TannerOleksiuk/ECE299/AlarmClock/schem.pdf

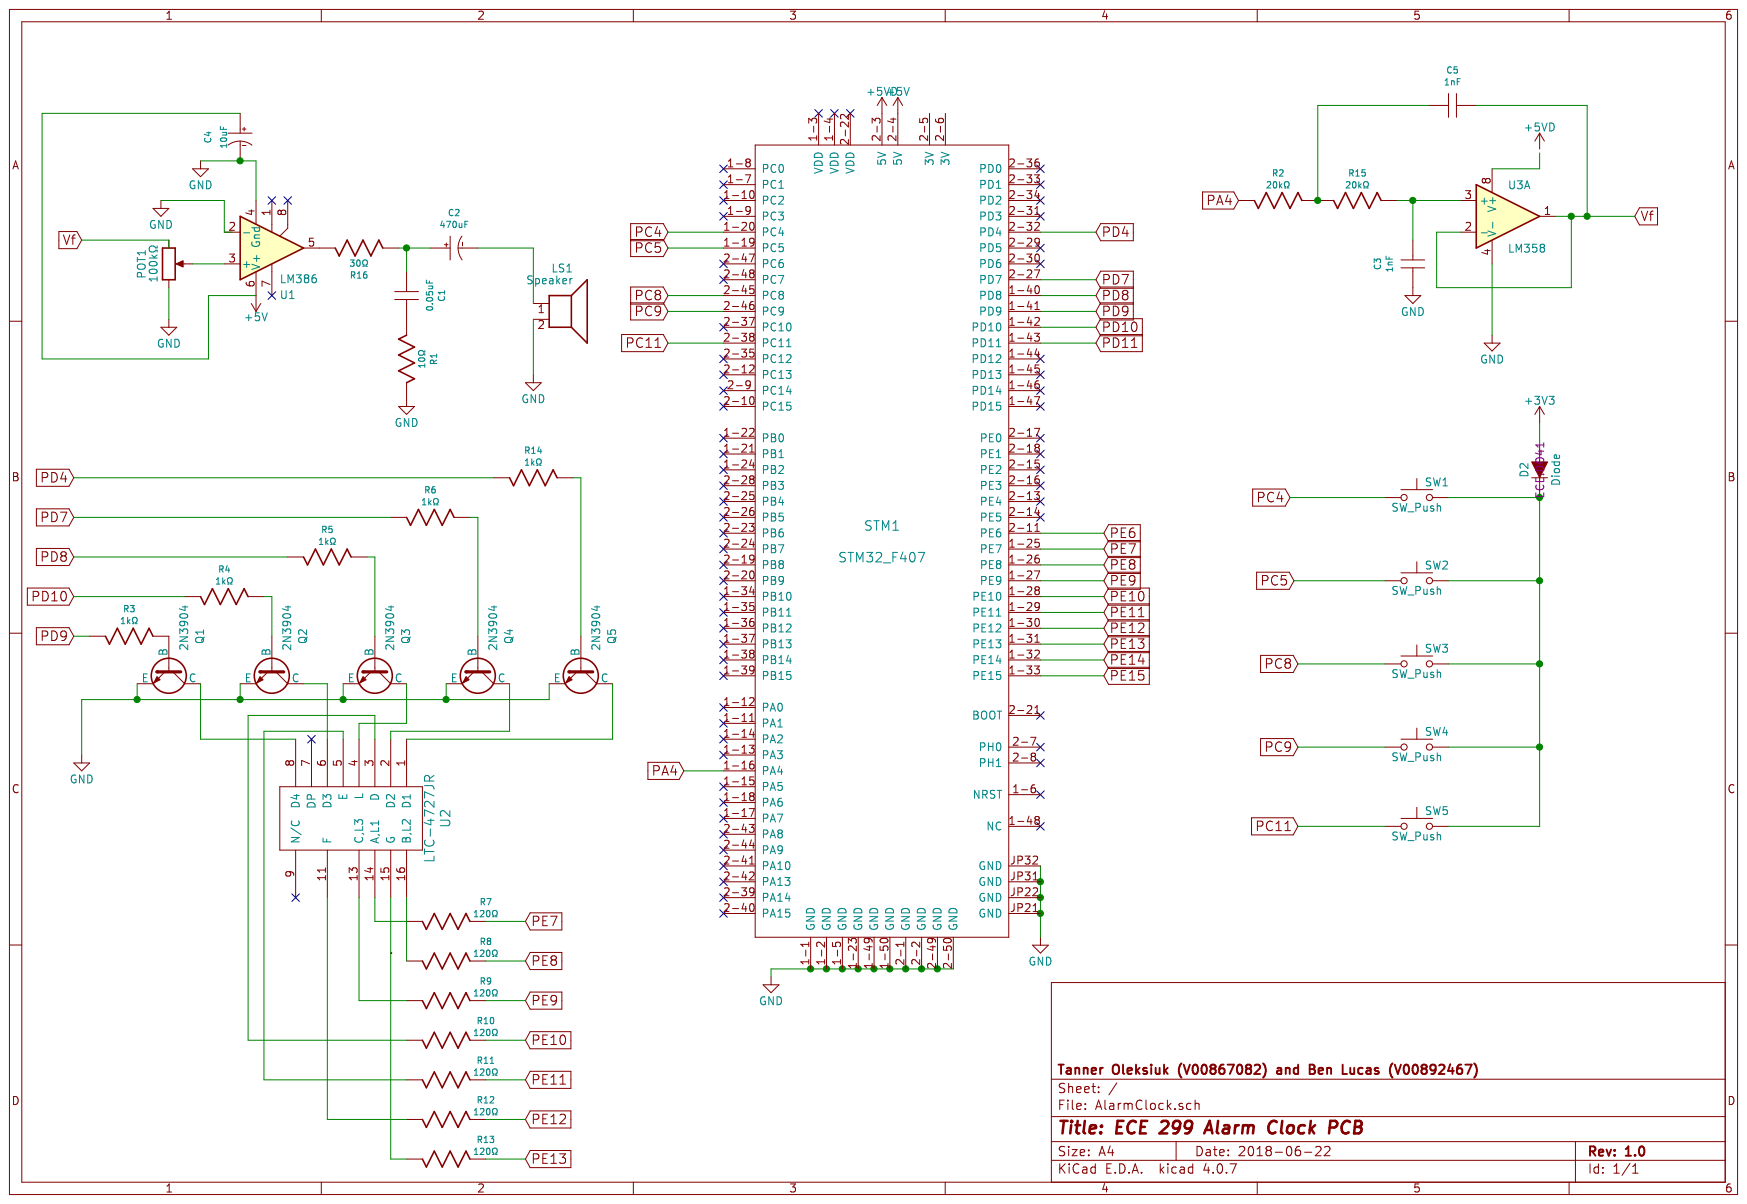
[picture p1: page 1]
