TannerOleksiuk/ECE299/AlarmClock/AlarmClock.kicad_pcb

## KiCad design AlarmClock/AlarmClock.kicad_pcb (2018-07-05)

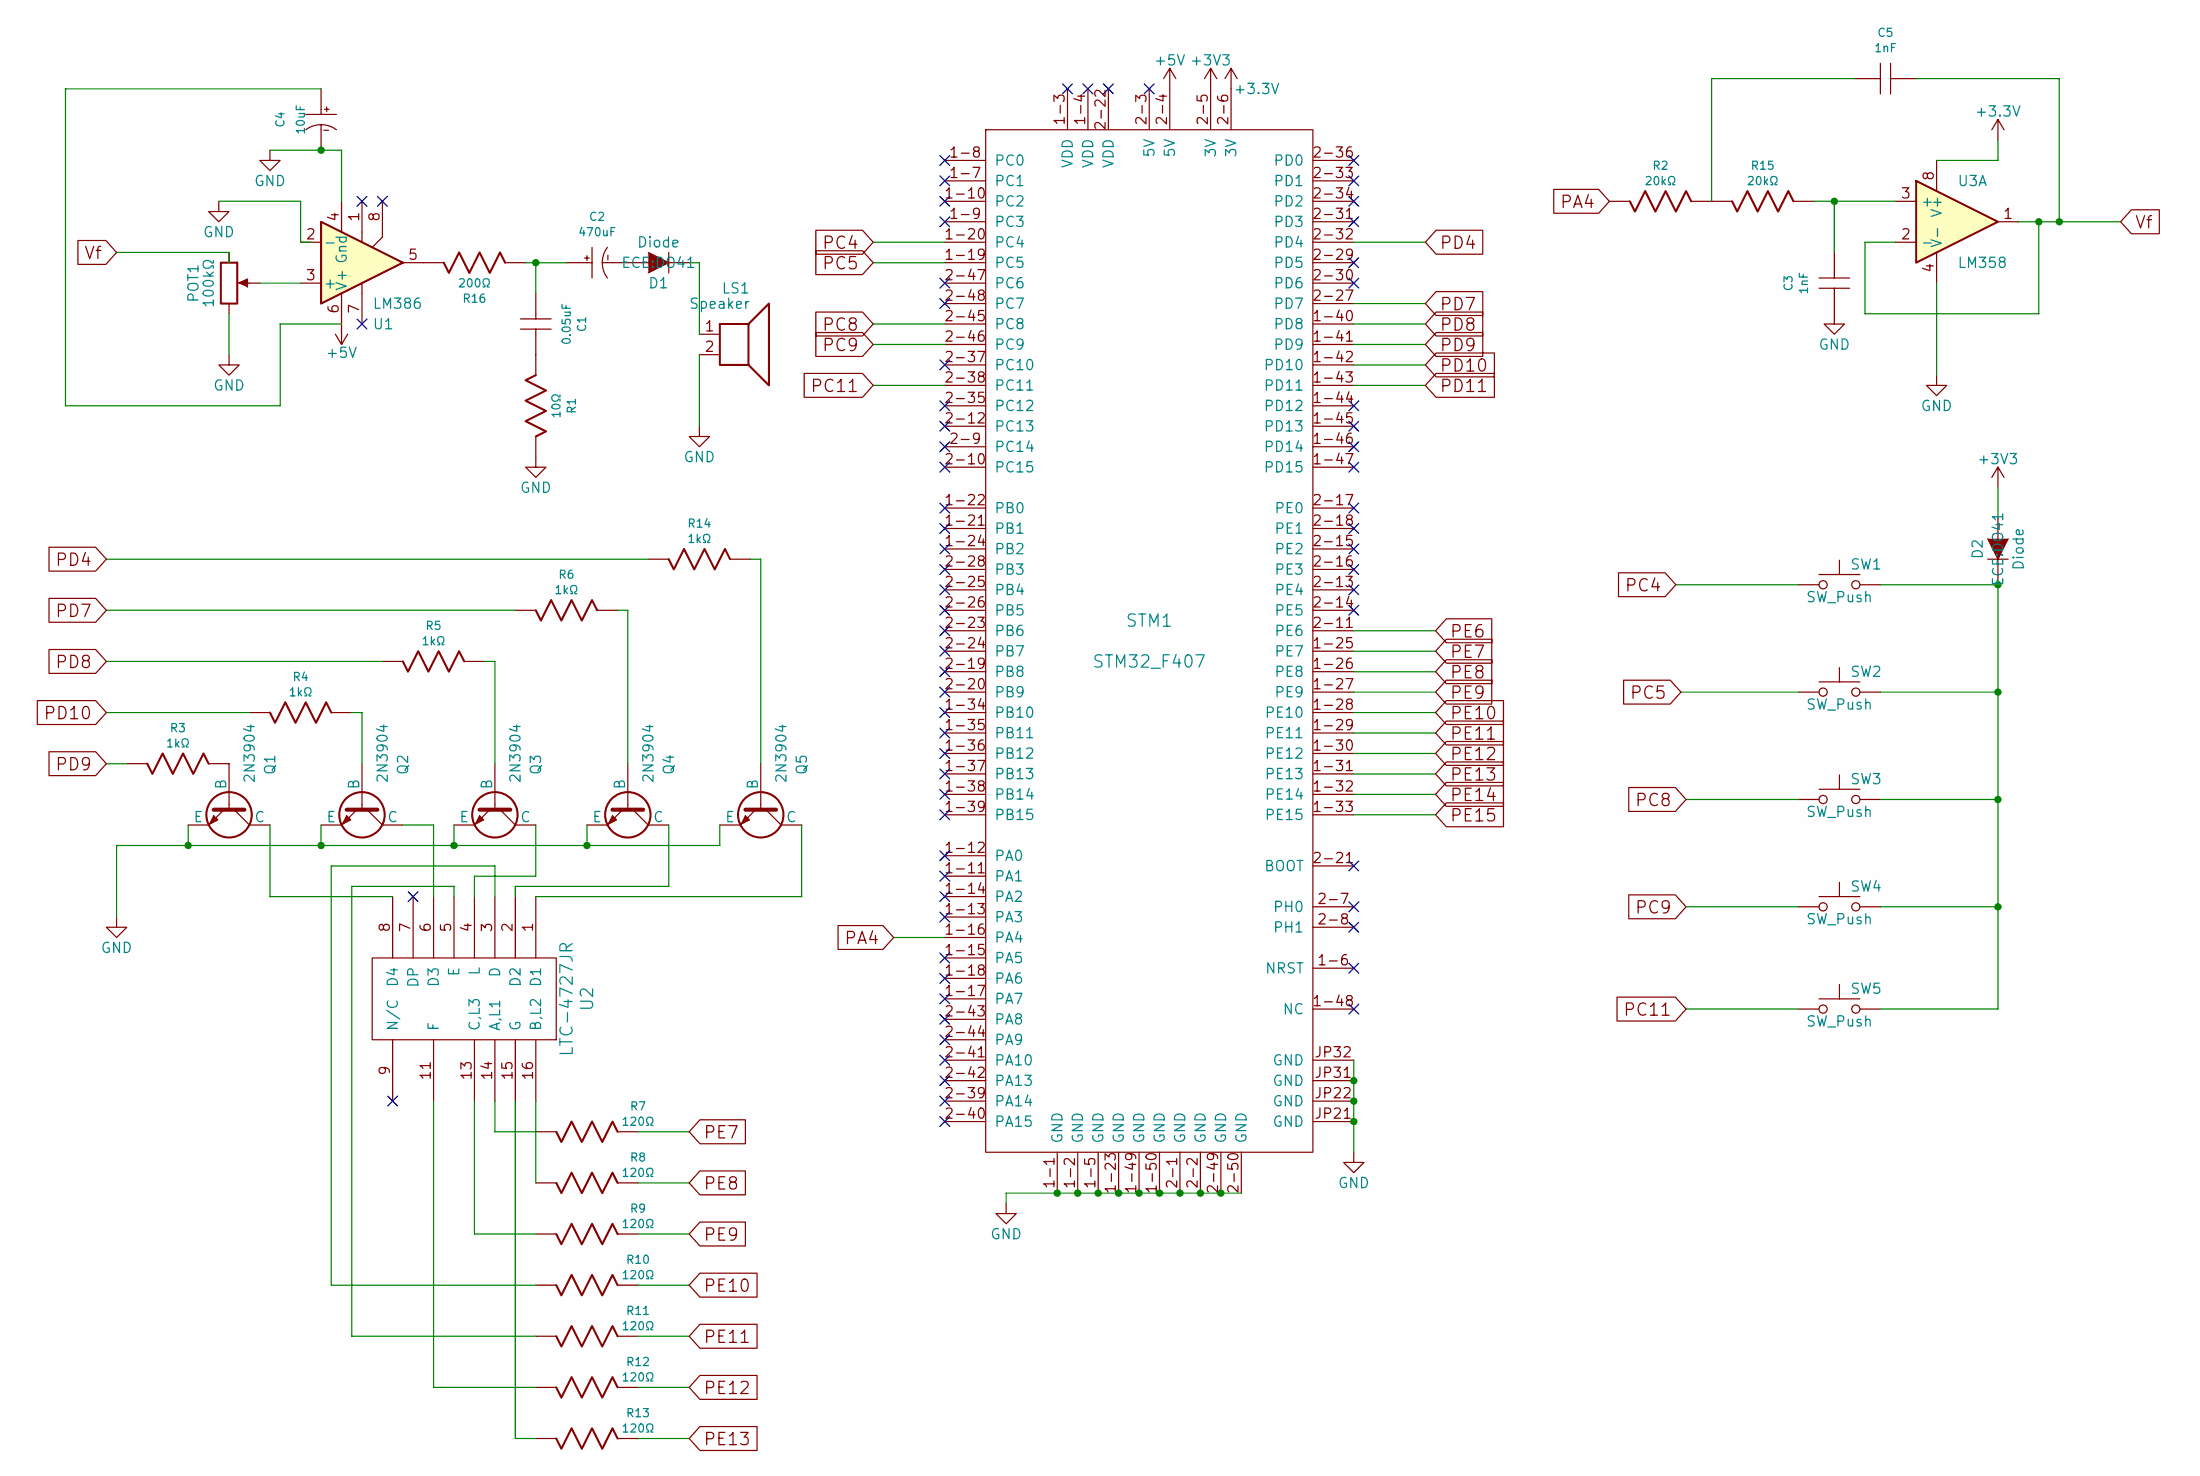
[picture p2: schematic AlarmClock.sch, ECE 299 Alarm Clock PCB]

Parts:
C1: 0.05uF; CAP.1
C2: 470uF; CAP_Pol_D6.3xH11.5xP2.0mm
C3, C5: 1nF; CAP.1
C4: 10uF; CAP_Pol_D6.3xH11.5xP2.0mm
D1, D2: Diode; DO41
LS1: Speaker; WireConnection_1.00mmDrill
POT1: 100kΩ; Potentiometer_Alps_RK09K_Horizontal
Q1, Q2, Q3, Q4, Q5: 2N3904; TO92
R1: 10Ω; RES.3
R2, R15: 20kΩ; RES.3
R3, R4, R5, R6, R14: 1kΩ; RES.3
R7, R8, R9, R10, R11, R12, R13: 120Ω; RES.3
R16: 200Ω; RES.3
STM1: STM32_F407; STM32_F4
SW1, SW2, SW3, SW4, SW5: SW_Push; SW_PUSH_6mm
U1: LM386; DIP8
U2: LTC-4727JR
U3: LM358; DIP8

Connections:
+5V: C4.1 (+), STM1.2-4 (5V), U1.6 (V+)
GND: C3.2, C4.2 (-), LS1.2, POT1.3, Q1.1 (E), Q2.1 (E), Q3.1 (E), Q4.1 (E), Q5.1 (E), R1.1, STM1.1-1 (GND), STM1.1-2 (GND), STM1.1-5 (GND), STM1.1-23 (GND), STM1.1-49 (GND), STM1.1-50 (GND), STM1.2-1 (GND), STM1.2-2 (GND), STM1.2-49 (GND), STM1.2-50 (GND), STM1.JP21 (GND), STM1.JP22 (GND), STM1.JP31 (GND), STM1.JP32 (GND), U1.2 (-), U1.4 (Gnd), U3.4 (V-)
unnamed: C1.1, C2.1 (+), R16.2
unnamed: C1.2, R1.2
unnamed: C2.2 (-), D1.A (Anode)
unnamed: C3.1, R15.1, U3.3 (+)
unnamed: C5.2, R2.1, R15.2
unnamed: D1.K (Cathode), LS1.1
unnamed: D2.K (Cathode), SW1.2, SW2.2, SW3.2, SW4.2, SW5.2
unnamed: POT1.2, U1.3 (+)
unnamed: Q1.2 (B), R3.1
unnamed: Q1.3 (C), U2.8 (D4)
unnamed: Q2.2 (B), R4.1
unnamed: Q2.3 (C), U2.6 (D3)
unnamed: Q3.2 (B), R5.1
unnamed: Q3.3 (C), U2.4 (L)
unnamed: Q4.2 (B), R6.1
unnamed: Q4.3 (C), U2.2 (D2)
unnamed: Q5.2 (B), R14.1
unnamed: Q5.3 (C), U2.1 (D1)
unnamed: R7.2, U2.14 (A,L1)
unnamed: R8.2, U2.16 (B,L2)
unnamed: R9.2, U2.13 (C,L3)
unnamed: R10.2, U2.3 (D)
unnamed: R11.2, U2.5 (E)
unnamed: R12.2, U2.11 (F)
unnamed: R13.2, U2.15 (G)
unnamed: R16.1, U1.5
PA4: R2.2, STM1.1-16 (PA4)
PC4: STM1.1-20 (PC4), SW1.1
PC5: STM1.1-19 (PC5), SW2.1
PC8: STM1.2-45 (PC8), SW3.1
PC9: STM1.2-46 (PC9), SW4.1
PC11: STM1.2-38 (PC11), SW5.1
PD4: R14.2, STM1.2-32 (PD4)
PD7: R6.2, STM1.2-27 (PD7)
PD8: R5.2, STM1.1-40 (PD8)
PD9: R3.2, STM1.1-41 (PD9)
PD10: R4.2, STM1.1-42 (PD10)
PD11: STM1.1-43 (PD11)
PE6: STM1.2-11 (PE6)
PE7: R7.1, STM1.1-25 (PE7)
PE8: R8.1, STM1.1-26 (PE8)
PE9: R9.1, STM1.1-27 (PE9)
PE10: R10.1, STM1.1-28 (PE10)
PE11: R11.1, STM1.1-29 (PE11)
PE12: R12.1, STM1.1-30 (PE12)
PE13: R13.1, STM1.1-31 (PE13)
PE14: STM1.1-32 (PE14)
PE15: STM1.1-33 (PE15)
Vf: C5.1, POT1.1, U3.1, U3.2 (-)

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
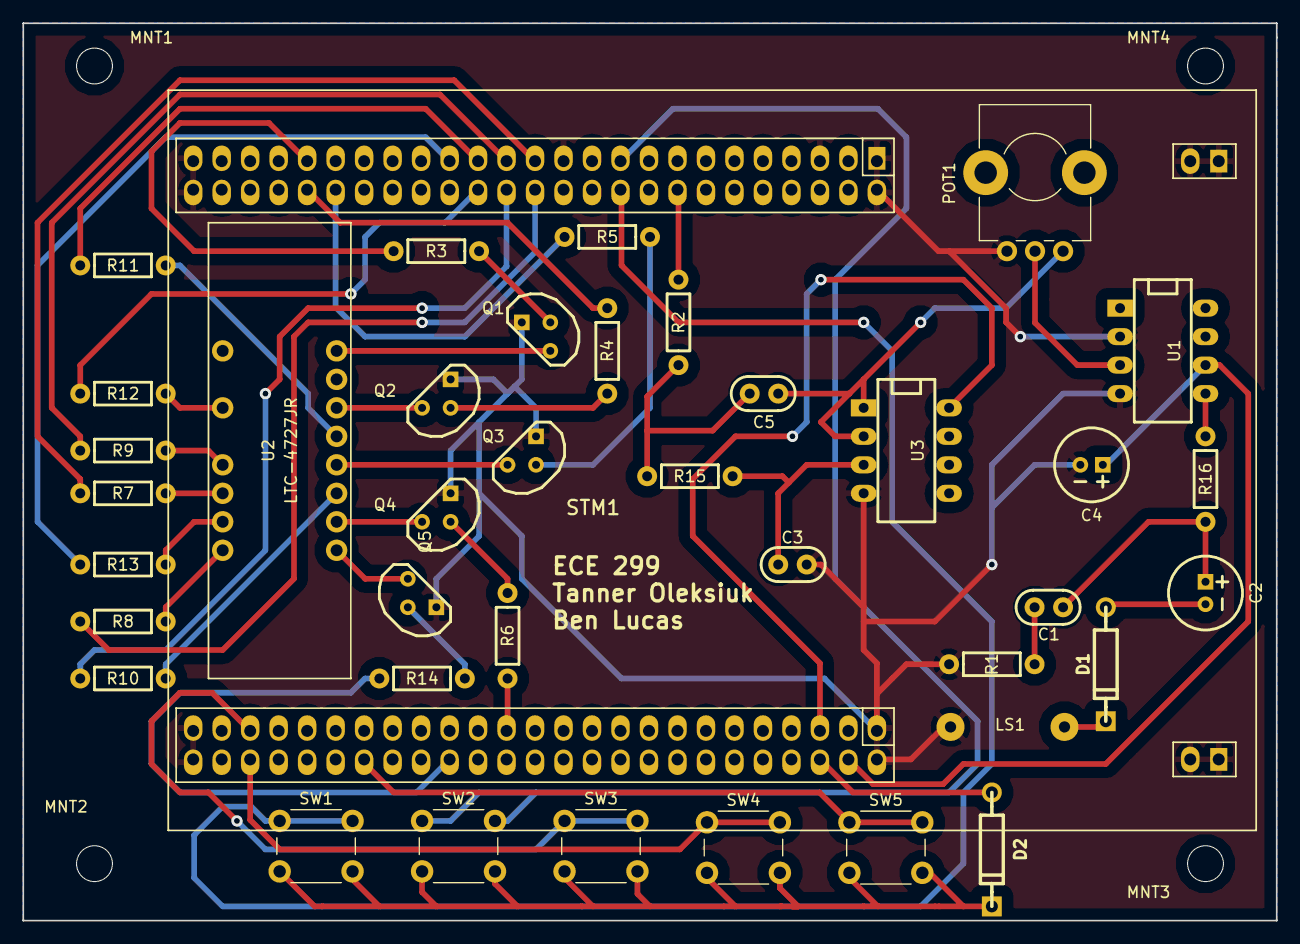
[picture p3: board AlarmClock.kicad_pcb from above]

Board: 2 copper layers, 111.8 x 80.0 mm, 43 parts (0 on the bottom side), 48 nets.

Other parts of the board:
MNT1, MNT2, MNT3, MNT4: MountingHole_3.2mm_M3
