TannerOleksiuk/ECE299/(commit log)

2018-06-15 KiCAD Files
    [AlarmClock.kicad_pcb, AlarmClock.sch]
2018-06-15 Added op amp circuit
    [AlarmClock.sch]
2018-06-19 STM Board added to op amp schematic
    [AlarmClock.sch]
2018-06-21 added labels to STM
    [AlarmClock.sch]
2018-06-21 7 seg
    [ECE 299 project.sch]
2018-06-21 changed name of 7segment for clarity
    [7Segment.sch]
2018-06-21 blah blah blah
    [7Segment.sch]
2018-06-21 push button circuit added
    [AlarmClock.sch]
2018-06-22 finalized for now...
    we should add circuit protection and stuff at some point but honestly its probably fine for assignment submission. Also added a cap between supply voltage and ground since as we saw in the lab, that filtered out a lot of the noise in our input signal, kinda guesstimated it but added space for optional capacitor
    [AlarmClock.sch]
2018-06-29 fixed op amp circuit and 7-seg
    [AlarmClock.sch]
2018-06-29 Modified schematic to include low pass filter and removed PB circuit
    [AlarmClock.sch]
2018-06-29 final schem
    [AlarmClock.sch]
2018-06-30 Added Footprints
    Added footprints to all components except 100kOhm potentiometer, also we need to add push buttons and figure out how they are going to work with the pull up/down resistors in the stm board
    [AlarmClock.sch]
2018-07-03 added pushbuttons
    [AlarmClock.sch]
2018-07-05 geber files and final pcb
    [AlarmClock-B.Cu.gbr, AlarmClock-B.Mask.gbr, AlarmClock-B.SilkS.gbr, AlarmClock-Edge.Cuts.gbr, AlarmClock-F.Cu.gbr, AlarmClock-F.Mask.gbr, AlarmClock-F.SilkS.gbr, AlarmClock-NPTH.drl]
2018-07-12 generated bom
    [AlarmClock.csv, AlarmClock.sch]
2018-07-31 added stuff, doesn't work but on right path
    [main.c]
